prowadnica/3DPoint/readme.md

# 3(r)D Point
Niniejsze repozytorium zawiera dokumentację wykonywania tabliczek z oznaczeniami w alfabecie Brajla z wykorzystaniem druku FDM.

Obecnie to repozytorium jest przygotowywane, ale już teraz znajdują się tu przykładowe modele i dokumentacja geometrii punktu Brajlowskiego.

[Dokumentacja](https://prowadnica.github.io/3DPoint)
